SugarFootPedals/Ultrasonic-Transducer-Tester/BOM_Transducer-TesterV3a_2025-11-17.csv

ID | Name | Designator | Footprint | Quantity
1 | 0.1 | C1,C4 | CAPACITOR-RADIAL-5MM | 2
2 | 220uf | C2 | CAP-TH_BD8.0-P3.5 | 1
3 | 10uf | C3 | CAP-TH_BD4.0-P1.50-D0.8-FD | 1
4 | 1uf | C5 | CAPACITOR BIPOLAR TH | 1
5 | +Transducer- | CN1 | SCREW_TERMINAL_2PIN_3.5MM_OSTTA024163 | 1
6 | 1N4007 | D1,D2 | 1N4007 | 2
7 | +12vDC- | DC1 | DC_JACK_2.1MMX5.5MM | 1
8 | 0.96OLED_i2C | DISP1 | 0.96OLED_4P | 1
9 | 220uH | L1 | IND-TH_BD7.7-P5.50-D0.7 | 1
10 | SEEED XIAO RP2040 | MOD1 | XIAO RP2040 THT_NEW | 1
11 | ACS712 Module | MOD3 | ACS712 CURRENT SENSOR MODULE | 1
12 | ZVN4424GTA | Q1 | SOT-223-3_L6.5-W3.4-P2.30-LS7.0-BR | 1
13 | 10 | R1 | R_1/4W | 1
14 | 10K | R2 | R_1/4W | 1
15 | L7805 | REG1 | LM7805 | 1
16 | START | SW1 | TACTILE-PTH-12MM | 1
