SugarFootPedals/Ultrasonic-Transducer-Tester/Schematic_Transducer-TesterV3a_2025-11-17.pdf

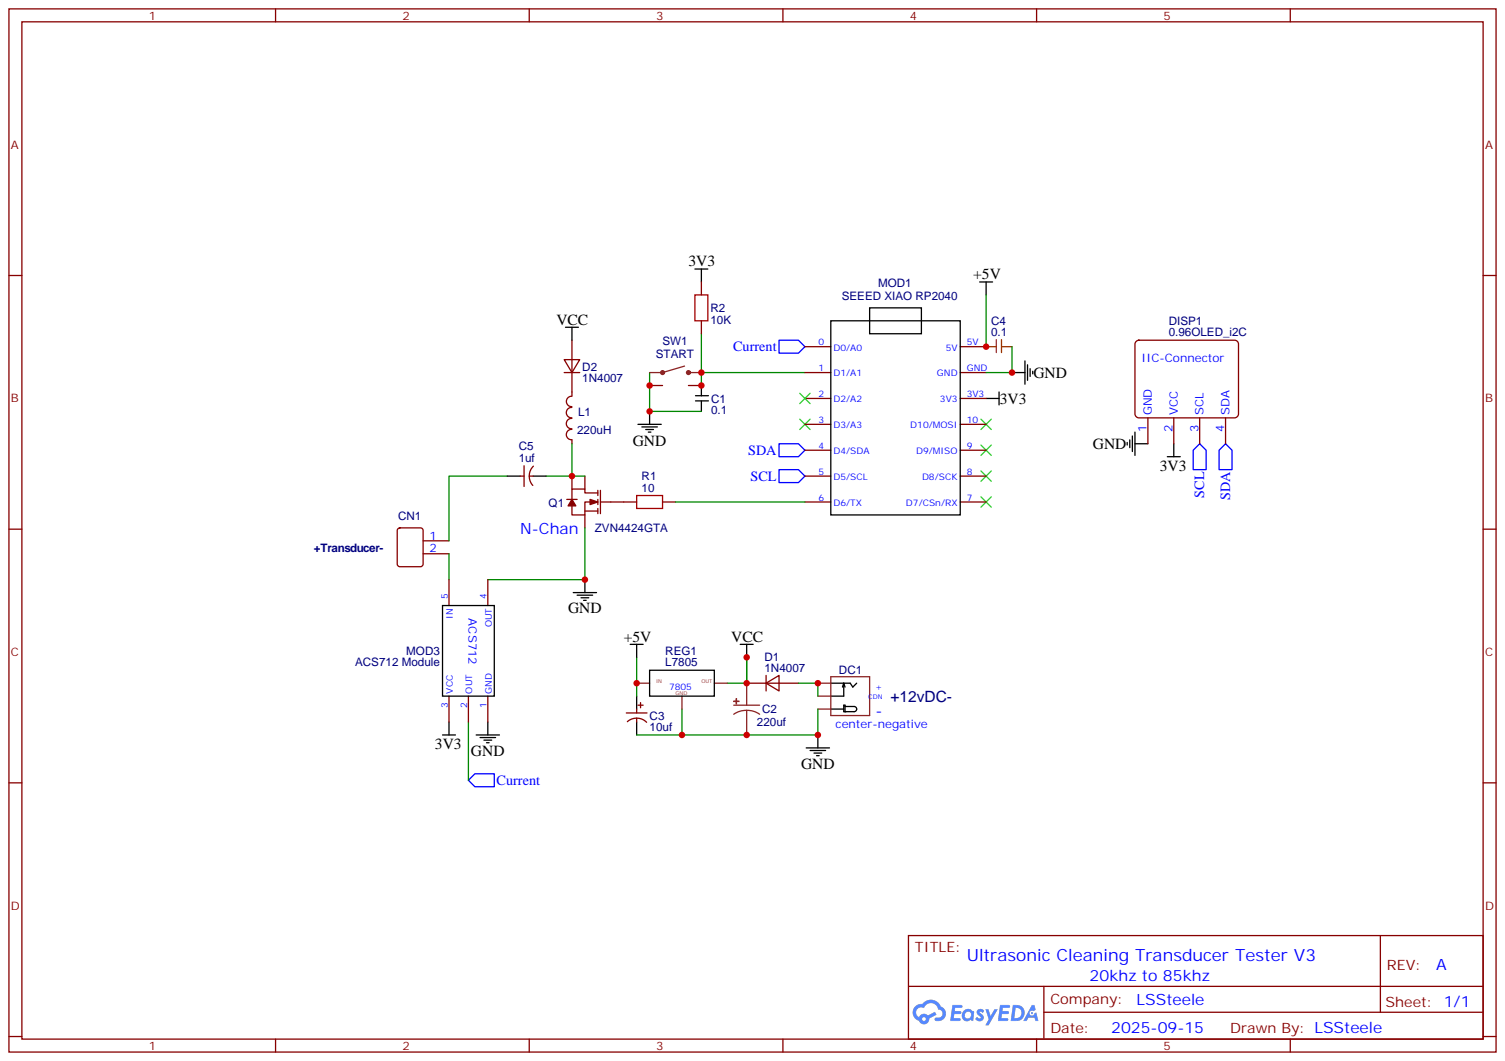
[picture p1: page 1]
