SugarFootPedals/Ultrasonic-Transducer-Tester/(list of files, drawings)

Other design files:
PCB_Transducer TesterV2.json
